Chrismettal/flipper-zero-backpacks/pcb/Raspberry/Raspberry.kicad_pcb

## KiCad design pcb/Raspberry/Raspberry.kicad_pcb (2024-04-27)

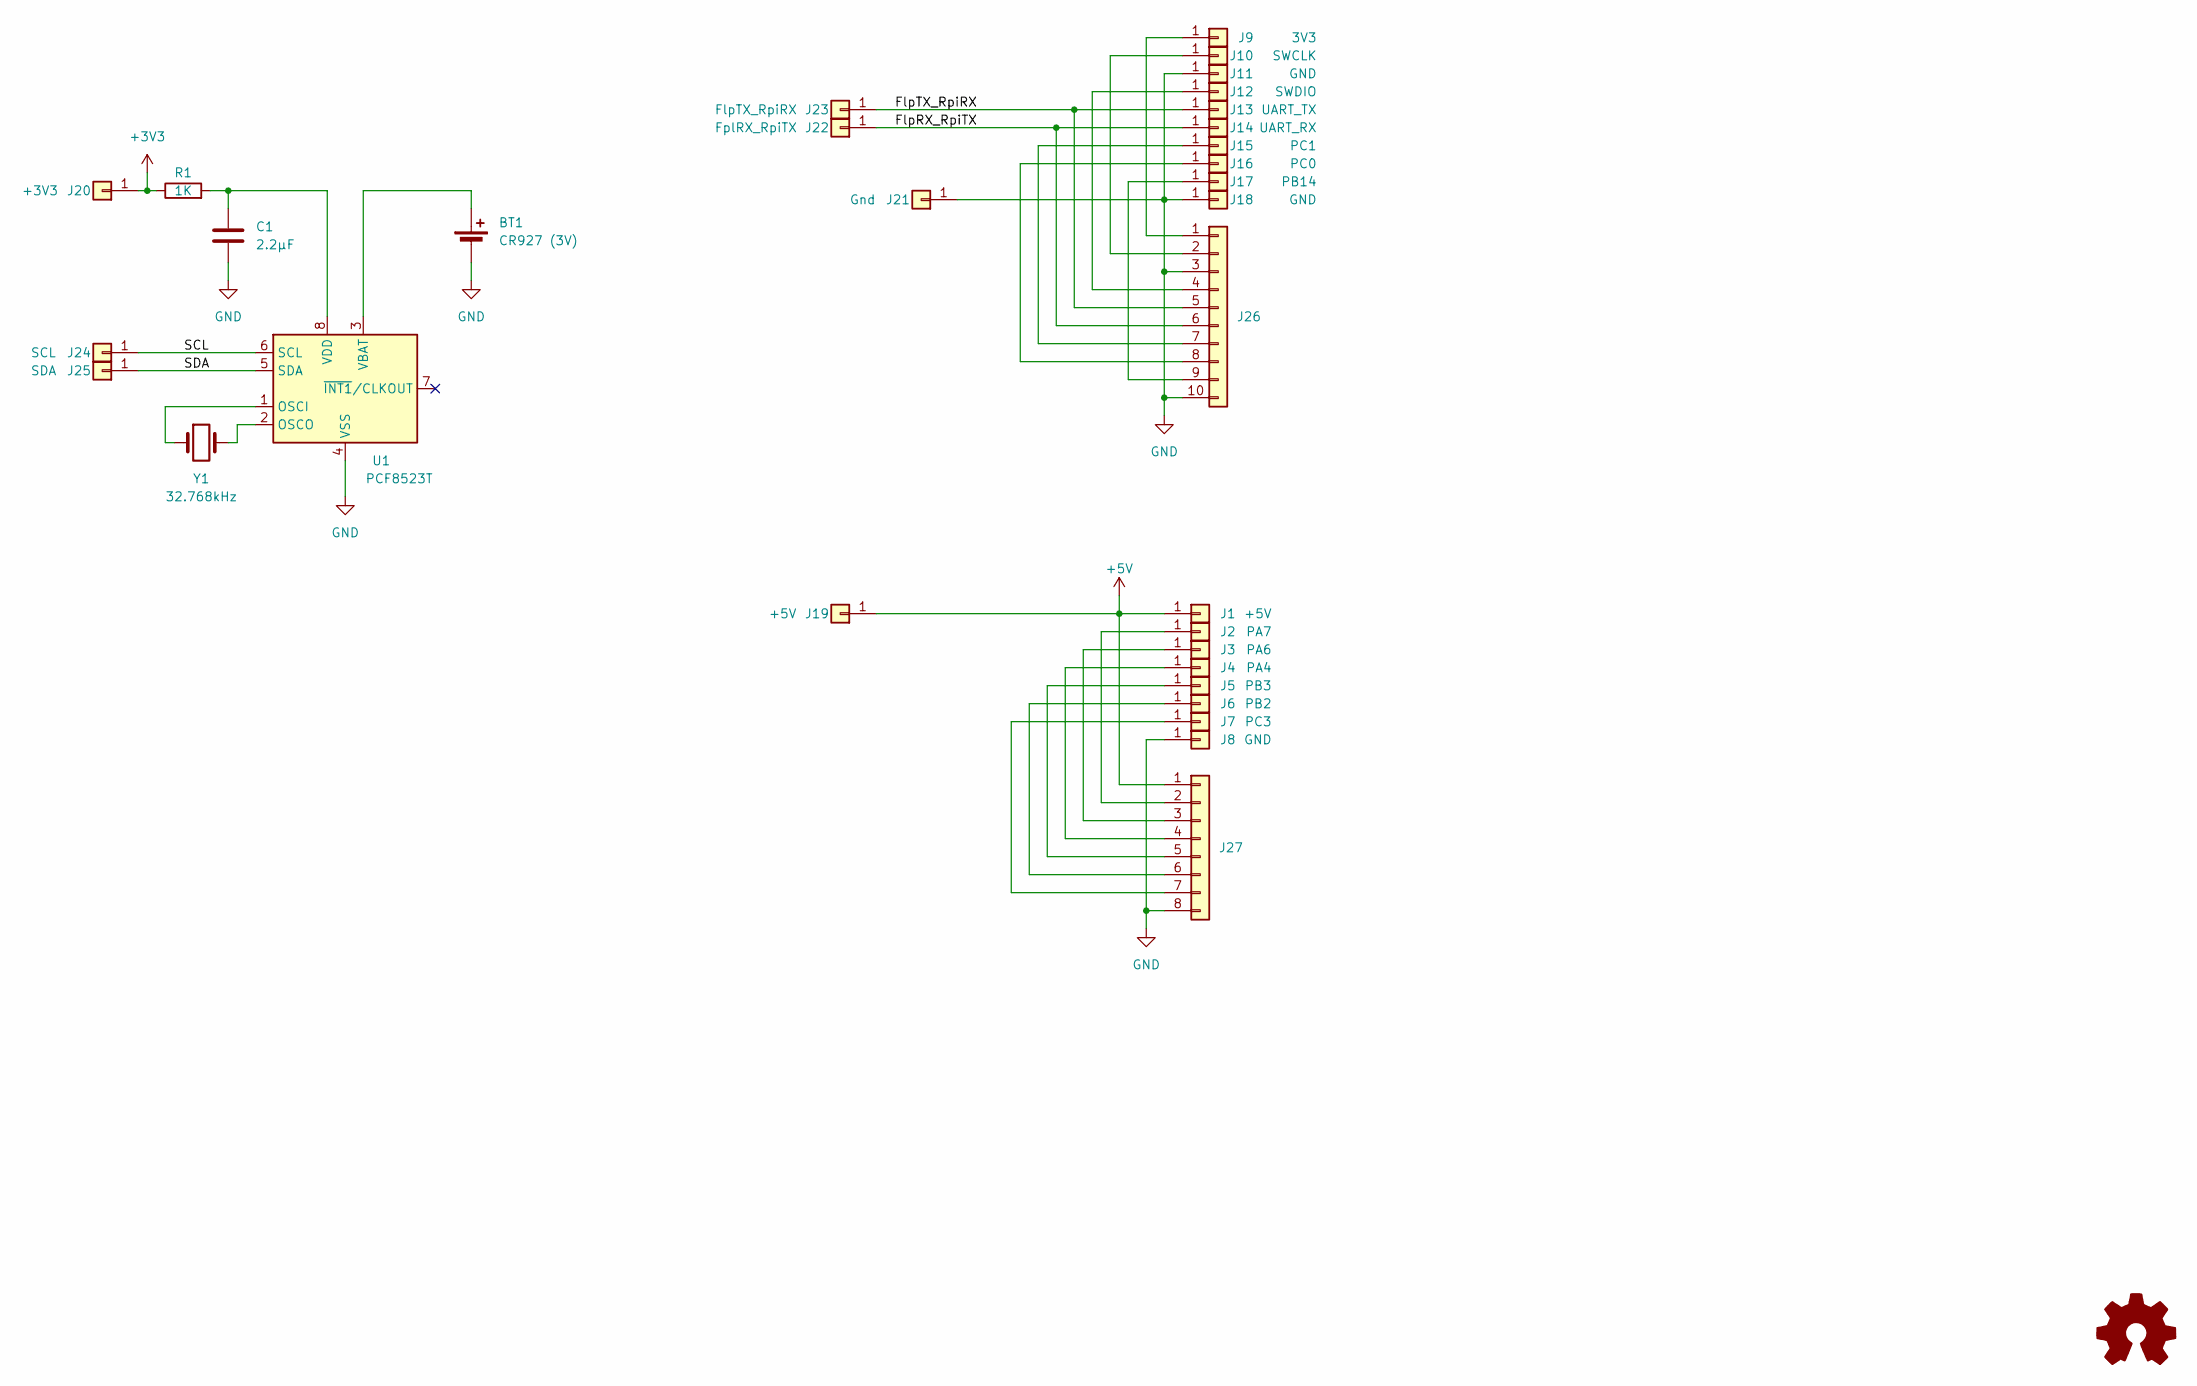
[picture p4: schematic Raspberry.kicad_sch]

Parts:
BT1: CR927 (3V); MY-927-01 CR927 Battery Holder; LCSC C964850
C1: 2.2µF; C_0603_1608Metric; LCSC C23630
J1: +5V; Board-Board-1mmEdge-2,54mm
J2: PA7; Board-Board-1mmEdge-2,54mm
J3: PA6; Board-Board-1mmEdge-2,54mm
J4: PA4; Board-Board-1mmEdge-2,54mm
J5: PB3; Board-Board-1mmEdge-2,54mm
J6: PB2; Board-Board-1mmEdge-2,54mm
J7: PC3; Board-Board-1mmEdge-2,54mm
J8, J11, J18: GND; Board-Board-1mmEdge-2,54mm
J9: 3V3; Board-Board-1mmEdge-2,54mm
J10: SWCLK; Board-Board-1mmEdge-2,54mm
J12: SWDIO; Board-Board-1mmEdge-2,54mm
J13: UART_TX; Board-Board-1mmEdge-2,54mm
J14: UART_RX; Board-Board-1mmEdge-2,54mm
J15: PC1; Board-Board-1mmEdge-2,54mm
J16: PC0; Board-Board-1mmEdge-2,54mm
J17: PB14; Board-Board-1mmEdge-2,54mm
J19: +5V; Protopin_Small
J20: +3V3; Protopin_Small
J21: Gnd; Protopin_Small
J22: FplRX_RpiTX; Protopin_Small
J23: FlpTX_RpiRX; Protopin_Small
J24: SCL; Protopin_Small
J25: SDA; Protopin_Small
J26: Conn_01x10; PinHeader_1x10_P2.54mm_Vertical
J27: Conn_01x08; PinHeader_1x08_P2.54mm_Vertical
R1: 1K; R_0603_1608Metric; LCSC C21190
U1: PCF8523T; SOIC-8_3.9x4.9mm_P1.27mm; LCSC C2651516
Y1: 32.768kHz; Crystal_SMD_3215-2Pin_3.2x1.5mm; LCSC C32346

Connections:
+3V3: J20.1, R1.1
+5V: J1.1, J19.1, J27.1
/FlpRX_RpiTX: J14.1, J22.1, J26.6
/FlpTX_RpiRX: J13.1, J23.1, J26.5
/SCL: J24.1, U1.6 (SCL)
/SDA: J25.1, U1.5 (SDA)
GND: BT1.2 (-), C1.2, J8.1, J11.1, J18.1, J21.1, J26.3, J26.10, J27.8, U1.4 (VSS)
unnamed: BT1.1 (+), U1.3 (VBAT)
unnamed: J2.1, J27.2
unnamed: J10.1, J26.2
unnamed: J12.1, J26.4
unnamed: J15.1, J26.7
unnamed: J16.1, J26.8
unnamed: J17.1, J26.9
unnamed: J9.1, J26.1
unnamed: J3.1, J27.3
unnamed: J4.1, J27.4
unnamed: J5.1, J27.5
unnamed: J6.1, J27.6
unnamed: J7.1, J27.7
unnamed: U1.1 (OSCI), Y1.1
unnamed: U1.2 (OSCO), Y1.2
unnamed: C1.1, R1.2, U1.8 (VDD)

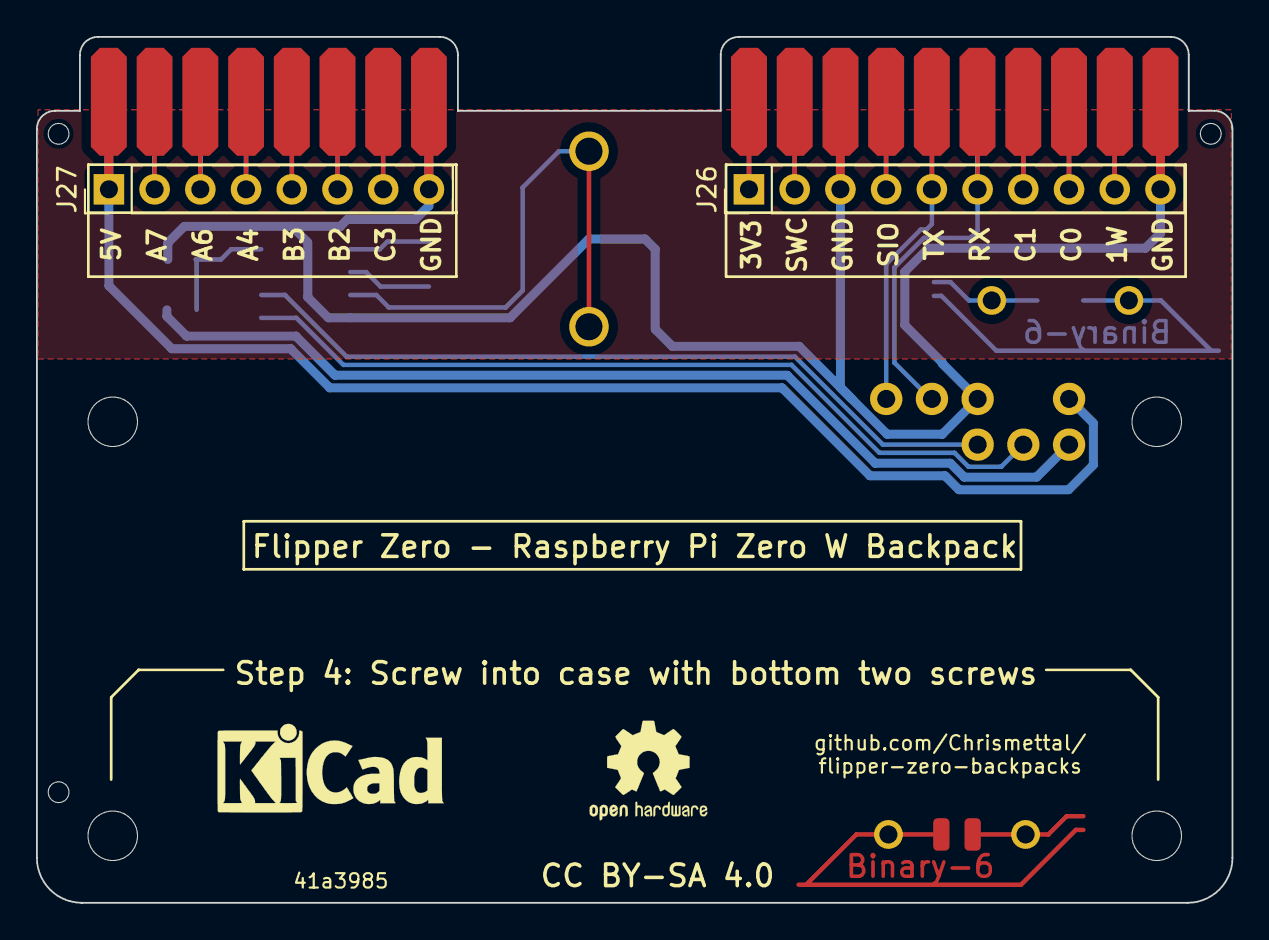
[picture p5: board Raspberry.kicad_pcb from above]

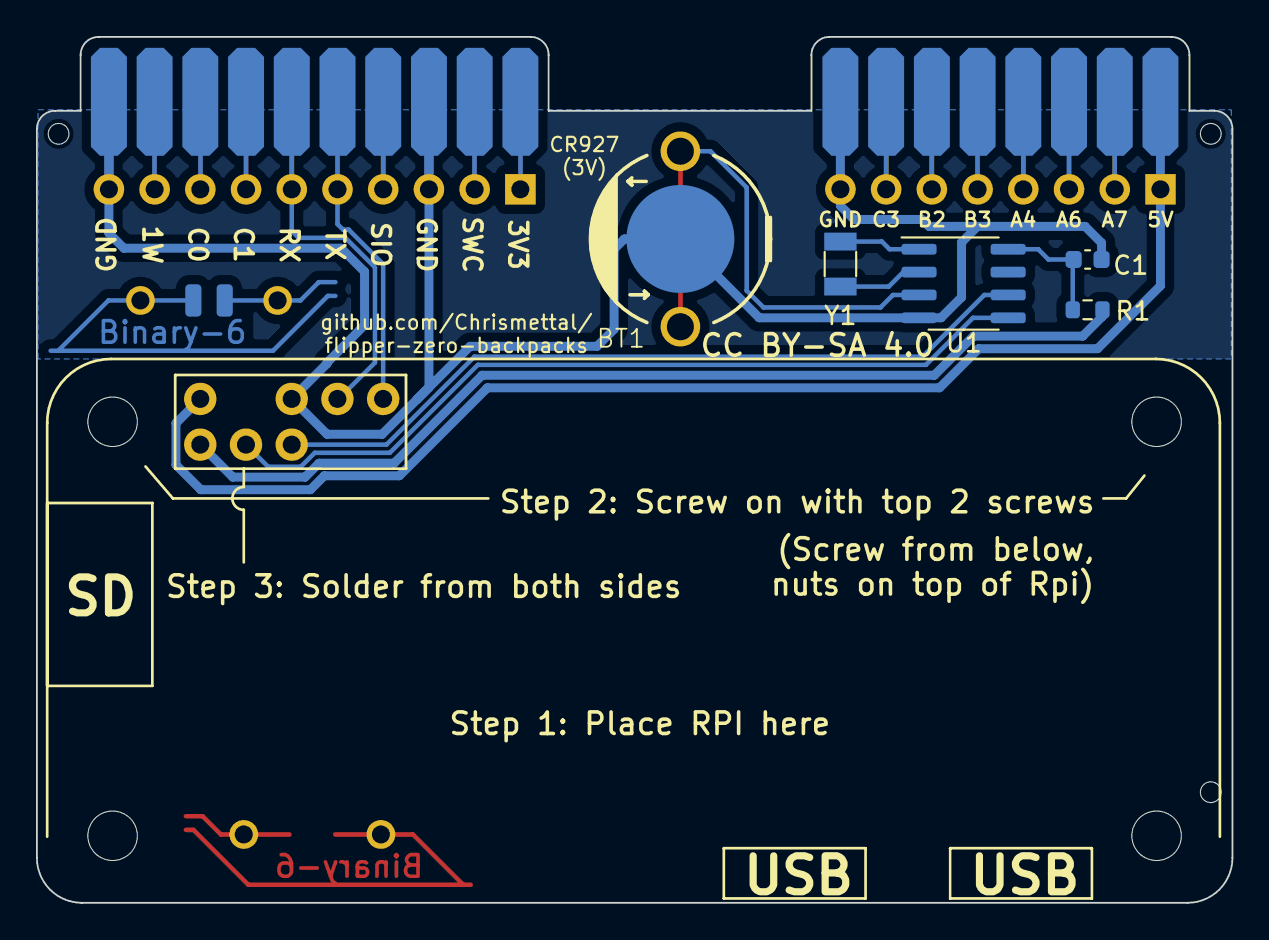
[picture p6: board Raspberry.kicad_pcb from below]

Board: 2 copper layers, 66.4 x 48.1 mm, 34 parts (8 on the bottom side), 23 nets.

Other parts of the board:
H7, H7#2: Symbol_Binary6; Binary_6_v0.1_tiny_silk
