Chrismettal/flipper-zero-backpacks/pcb/Connecting-piece/Connecting-piece.kicad_pcb

## KiCad design pcb/Connecting-piece/Connecting-piece.kicad_pcb (2024-04-27)

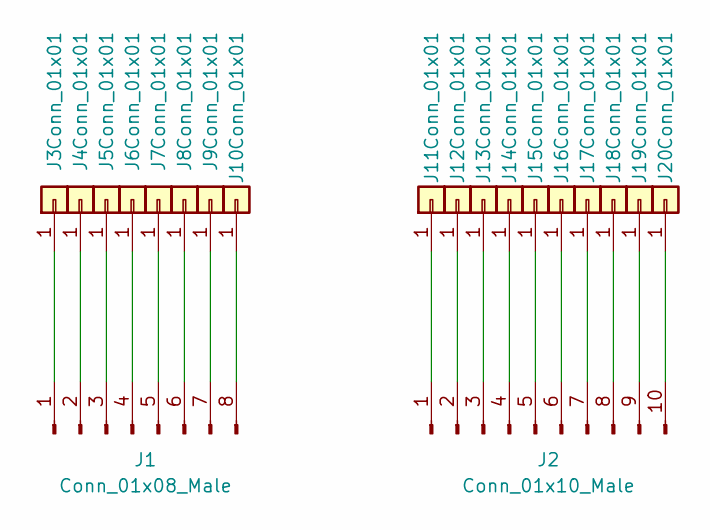
[picture p7: schematic Connecting-piece.kicad_sch, Connecting Piece]

Parts:
J1: Conn_01x08_Male; PinSocket_1x08_P2.54mm_Vertical
J2: Conn_01x10_Male; PinSocket_1x10_P2.54mm_Vertical
J3, J4, J5, J6, J7, J8, J9, J10, J11, J12, J13, J14, J15, J16, J17, J18, J19, J20: Conn_01x01; Board-Board-1mmSlot-2,54mm

Connections:
unnamed: J1.1, J3.1
unnamed: J1.2, J4.1
unnamed: J1.3, J5.1
unnamed: J1.4, J6.1
unnamed: J1.5, J7.1
unnamed: J1.6, J8.1
unnamed: J1.7, J9.1
unnamed: J1.8, J10.1
unnamed: J2.1, J11.1
unnamed: J2.2, J12.1
unnamed: J2.3, J13.1
unnamed: J2.4, J14.1
unnamed: J2.5, J15.1
unnamed: J2.6, J16.1
unnamed: J2.7, J17.1
unnamed: J2.8, J18.1
unnamed: J2.9, J19.1
unnamed: J2.10, J20.1

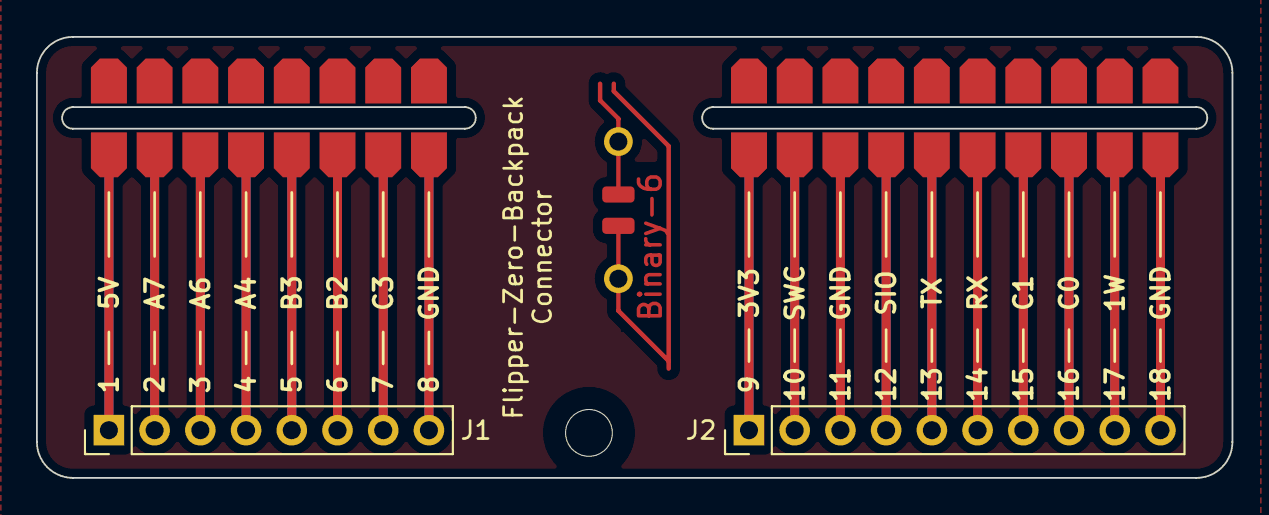
[picture p8: board Connecting-piece.kicad_pcb from above]

Board: 2 copper layers, 66.4 x 24.5 mm, 22 parts (0 on the bottom side), 18 nets.

Other parts of the board:
H7: Symbol_Binary6; Binary_6_v0.1_tiny_silk
MK2: Mounting_Hole; EigenesMountingHole_2.6mm_M2.5_Small
