Chrismettal/flipper-zero-backpacks/pcb/Protoboard/Protoboard.kicad_pcb

## KiCad design pcb/Protoboard/Protoboard.kicad_pcb (2023-05-01)

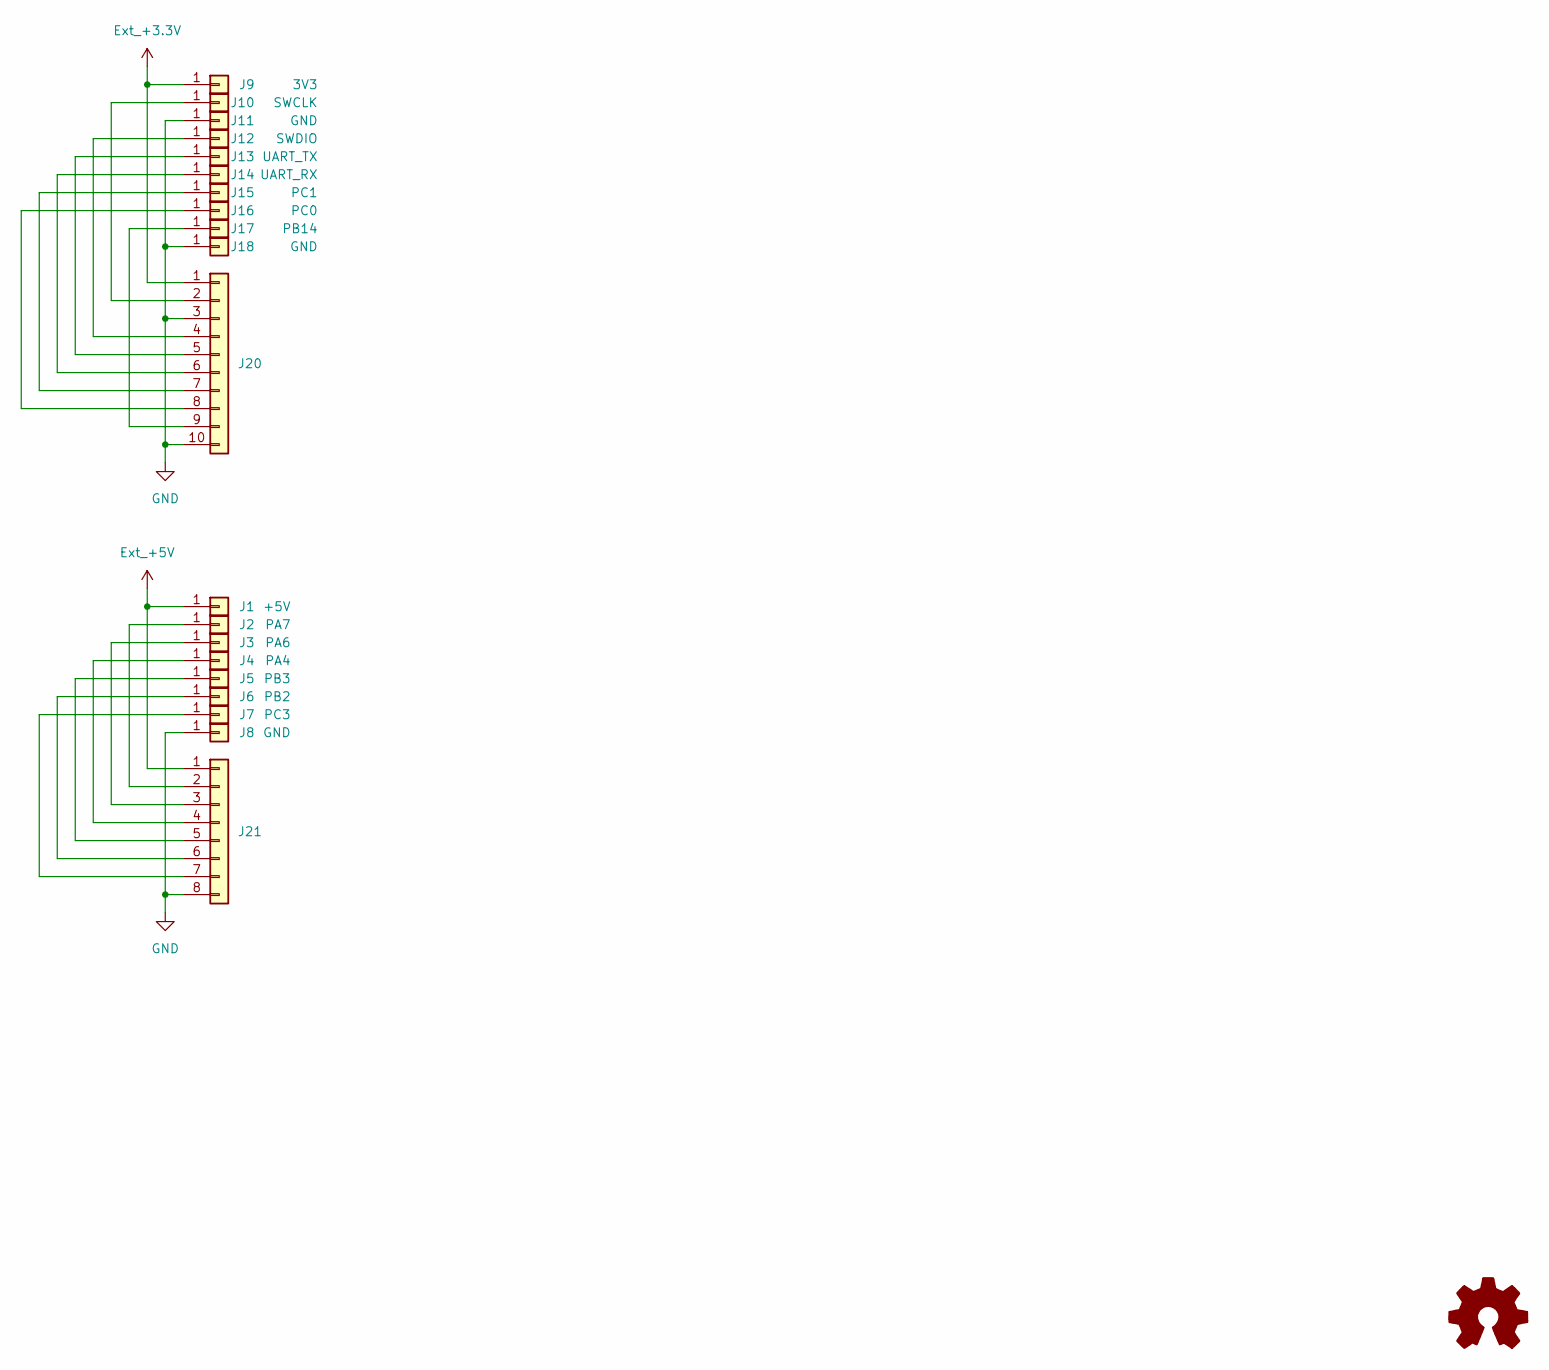
[picture p9: schematic Protoboard.kicad_sch, Clean]

Parts:
J1: +5V; Board-Board-1mmEdge-2,54mm
J2: PA7; Board-Board-1mmEdge-2,54mm
J3: PA6; Board-Board-1mmEdge-2,54mm
J4: PA4; Board-Board-1mmEdge-2,54mm
J5: PB3; Board-Board-1mmEdge-2,54mm
J6: PB2; Board-Board-1mmEdge-2,54mm
J7: PC3; Board-Board-1mmEdge-2,54mm
J8, J11, J18: GND; Board-Board-1mmEdge-2,54mm
J9: 3V3; Board-Board-1mmEdge-2,54mm
J10: SWCLK; Board-Board-1mmEdge-2,54mm
J12: SWDIO; Board-Board-1mmEdge-2,54mm
J13: UART_TX; Board-Board-1mmEdge-2,54mm
J14: UART_RX; Board-Board-1mmEdge-2,54mm
J15: PC1; Board-Board-1mmEdge-2,54mm
J16: PC0; Board-Board-1mmEdge-2,54mm
J17: PB14; Board-Board-1mmEdge-2,54mm
J20: Conn_01x10; PinHeader_1x10_P2.54mm_Vertical
J21: Conn_01x08; PinHeader_1x08_P2.54mm_Vertical

Connections:
Ext_+3.3V: J9.1, J20.1
Ext_+5V: J1.1, J21.1
GND: J8.1, J11.1, J18.1, J20.3, J20.10, J21.8
unnamed: J2.1, J21.2
unnamed: J10.1, J20.2
unnamed: J12.1, J20.4
unnamed: J13.1, J20.5
unnamed: J14.1, J20.6
unnamed: J15.1, J20.7
unnamed: J16.1, J20.8
unnamed: J17.1, J20.9
unnamed: J3.1, J21.3
unnamed: J4.1, J21.4
unnamed: J5.1, J21.5
unnamed: J6.1, J21.6
unnamed: J7.1, J21.7

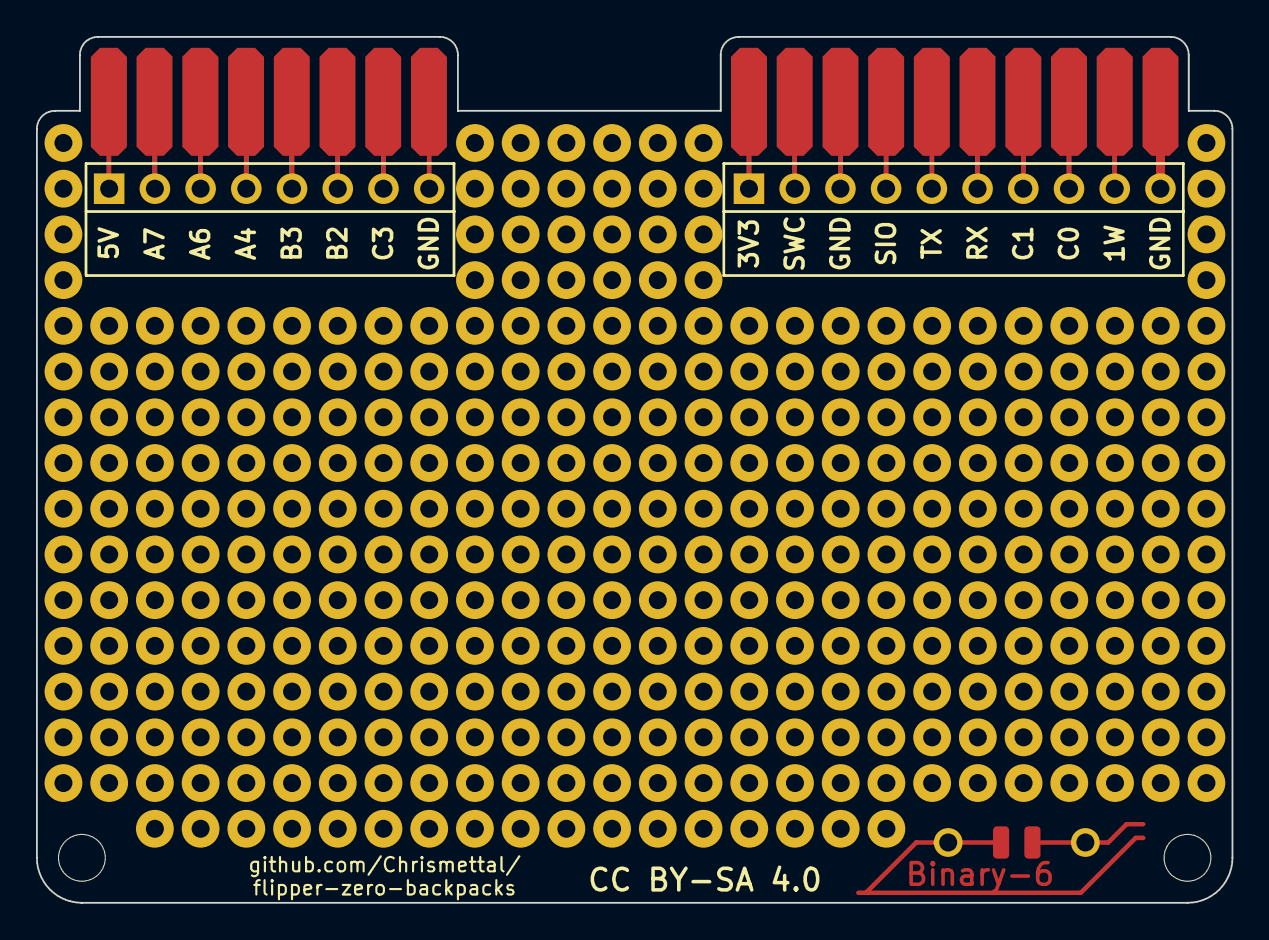
[picture p10: board Protoboard.kicad_pcb from above]

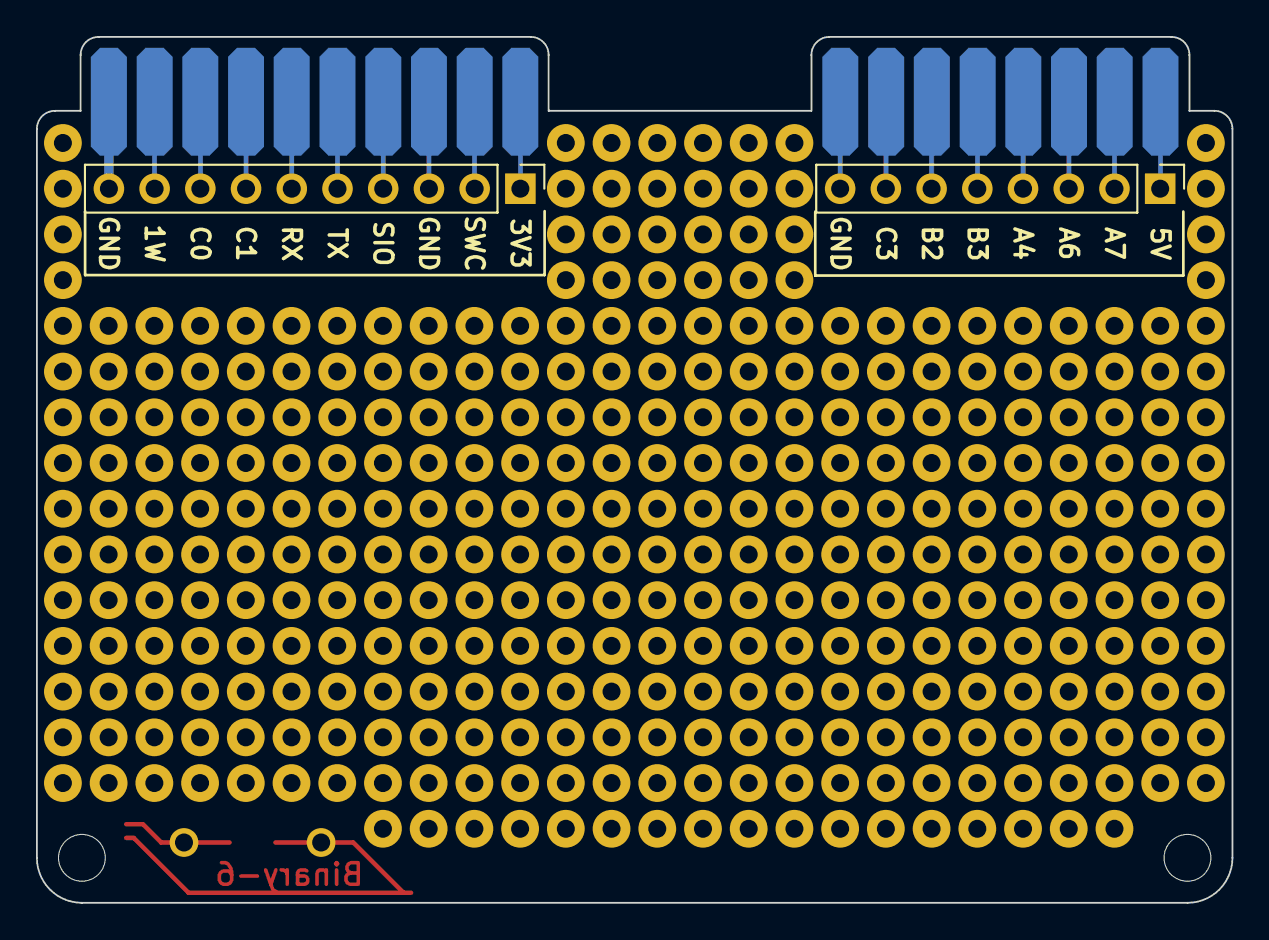
[picture p11: board Protoboard.kicad_pcb from below]

Board: 2 copper layers, 66.4 x 48.1 mm, 23 parts (2 on the bottom side), 16 nets.

Other parts of the board:
H7: Symbol_Binary6; Binary_6_v0.1_tiny_silk
MK2, MK2#2: Mounting_Hole; EigenesMountingHole_2.6mm_M2.5_Small
