Chrismettal/flipper-zero-backpacks/(notices)

Notices in the files:
pcb/Protoboard/Protoboard.kicad_pcb:
CC BY-SA 4.0
